PowerFeather/powerfeather-kicad-lib/3d/POGO.stp

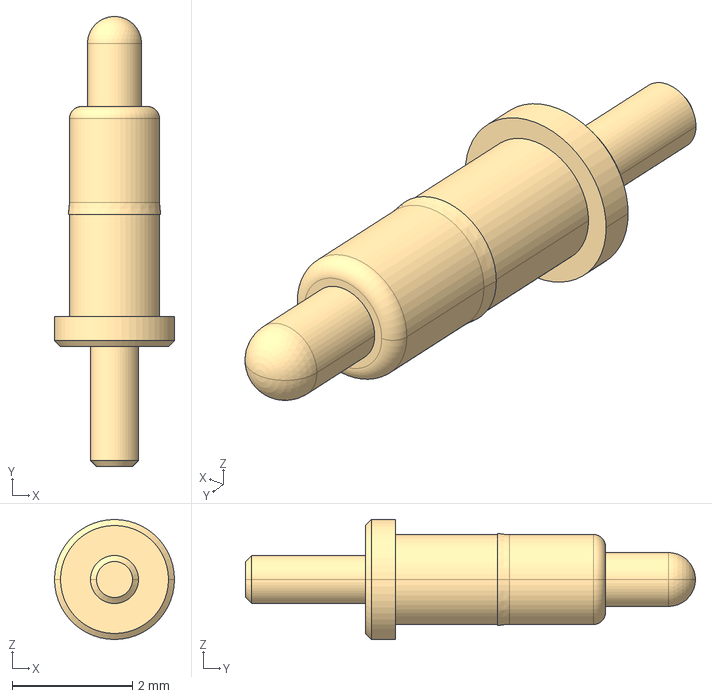
[picture p1: CAD file, 2024-10-25]
3d/POGO.stp
2.00 x 7.50 x 2.00 mm
