PowerFeather/powerfeather-kicad-lib/3d/TPS2120.STEP

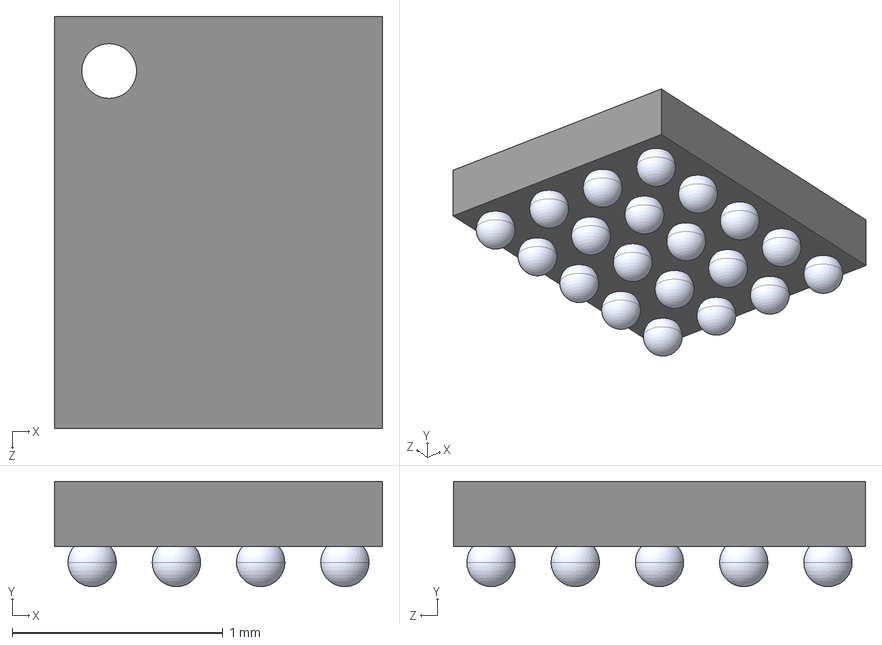
[picture p2: CAD file, 2024-10-25]
3d/TPS2120.STEP
1.56 x 0.5 x 1.96 mm
