PowerFeather/powerfeather-kicad-lib/3d/JST_SH_SM02B.STEP

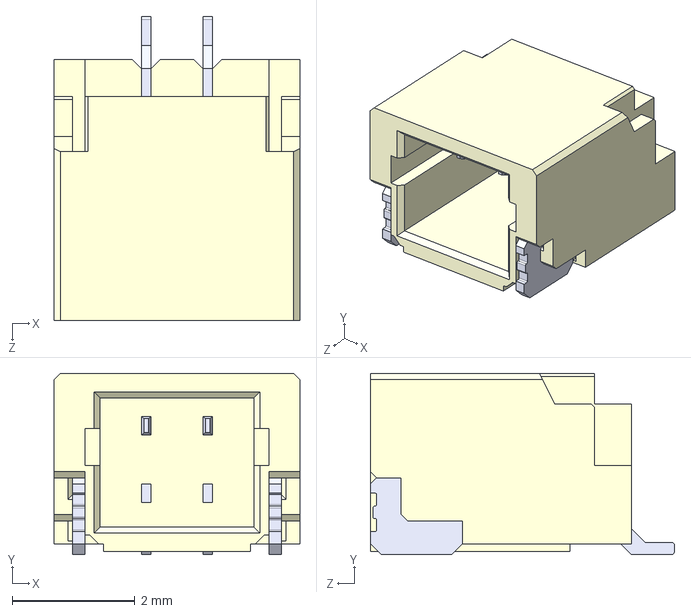
[picture p3: CAD file, 2024-10-20]
3d/JST_SH_SM02B.STEP
4.00 x 2.95 x 4.95 mm
