PowerFeather/powerfeather-kicad-lib/3d/DMN3016LFDE.STEP

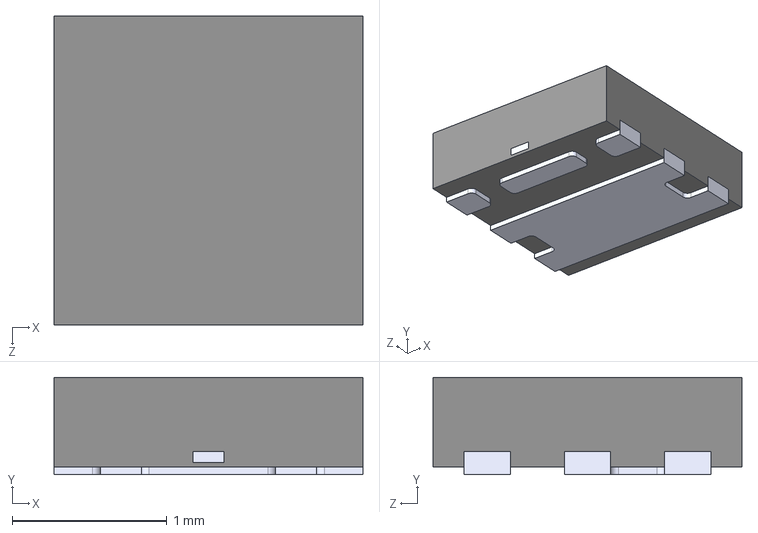
[picture p4: CAD file, 2024-10-20]
3d/DMN3016LFDE.STEP
2.00 x 0.63 x 2.00 mm
