PowerFeather/powerfeather-kicad-lib/3d/EVQP7.STEP

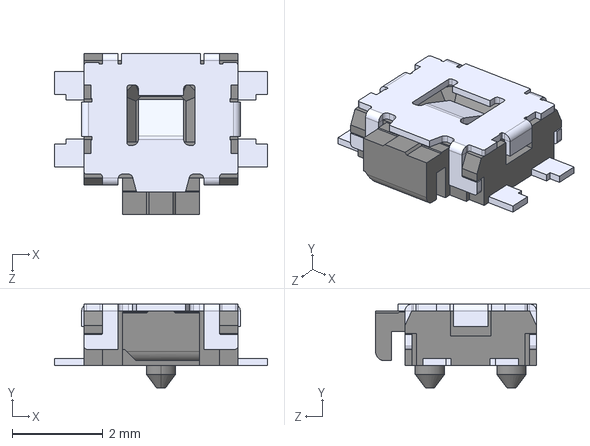
[picture p5: CAD file, 2024-10-20]
3d/EVQP7.STEP
4.70 x 1.85 x 3.55 mm
