PowerFeather/powerfeather-kicad-lib/3d/FAN48623.step

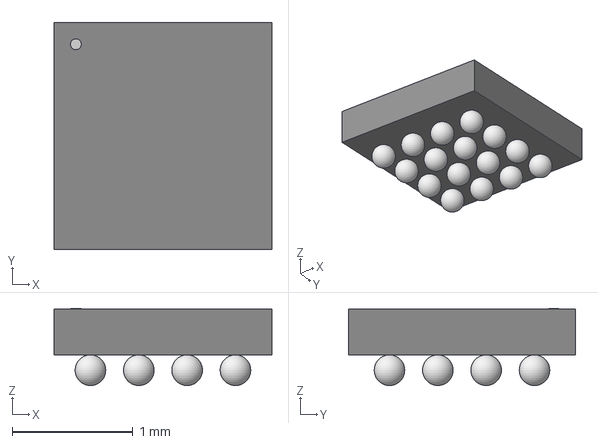
[picture p6: CAD file, 2024-10-20]
3d/FAN48623.step
1.80 x 1.88 x 0.638 mm
