PowerFeather/powerfeather-kicad-lib/3d/BQ25622E.stp

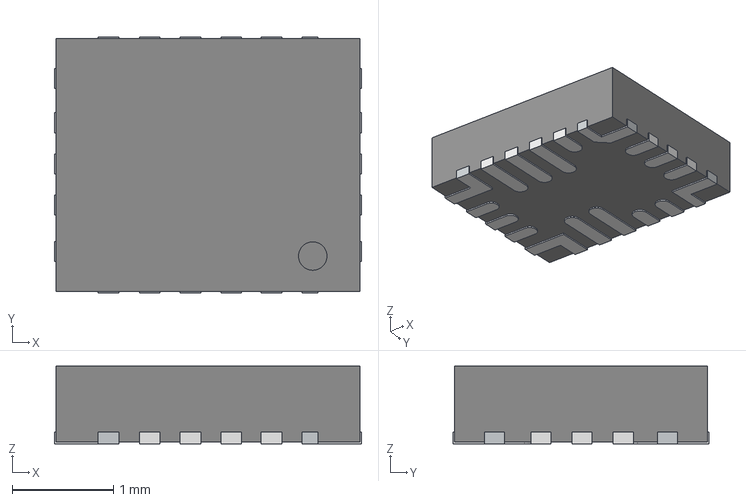
[picture p7: CAD file, 2024-10-20]
3d/BQ25622E.stp
3.03 x 2.52 x 0.77 mm
