PowerFeather/powerfeather-kicad-lib/sheets/bq25622e.kicad_sch

## KiCad design sheets/bq25622e.kicad_sch (2024-11-01)

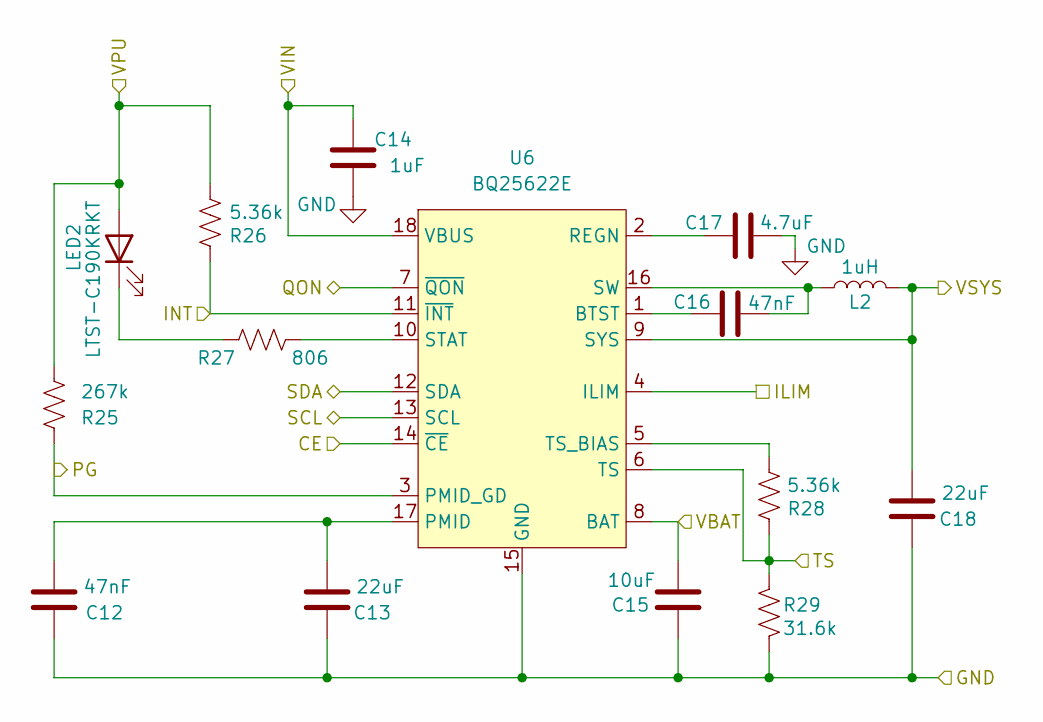
[picture p8: schematic bq25622e.kicad_sch]

Parts:
C12, C16: 47nF; C_0402_1005Metric; MPN 791-0402B473K250CT
C13, C18: 22uF; C_0805_2012Metric; MPN 187-CL21A226MAYNNNE
C14: 1uF; C_0402_1005Metric; MPN 81-GRM155R61E105MA2J
C15: 10uF; C_0603_1608Metric; MPN 187-CL10A106KP8NNWC
C17: 4.7uF; C_0603_1608Metric; MPN 187-CL10A475KP8NNND
L2: 1uH; L_1008_2520Metric; MPN 815-AOTB252010S1R0MT
LED2: LTST-C190KRKT; LED_0603_1608Metric; MPN 859-LTST-C190KRKT
R25: 267k; R_0402_1005Metric; MPN 603-AC0402FR-07267KL
R26, R28: 5.36k; R_0402_1005Metric; MPN 603-RC0402FR-135K36L
R27: 806; R_0402_1005Metric; MPN 603-RC0402FR-7W806RL
R29: 31.6k; R_0402_1005Metric; MPN 603-RC0402FR-7D31K6L
U6: BQ25622E; MPN 595-BQ25622RYKR

Connections:
CE: U6.14 (~CE)
GND: C12.2, C13.2, C14.2, C15.1, C17.1, C18.2, R29.1, U6.15 (GND)
ILIM: U6.4 (ILIM)
INT: R26.2, U6.11 (~INT)
unnamed: C12.1, C13.1, U6.17 (PMID)
unnamed: C16.1, L2.1, U6.16 (SW)
unnamed: C16.2, U6.1 (BTST)
unnamed: C17.2, U6.2 (REGN)
unnamed: LED2.1 (K), R27.1
unnamed: R27.2, U6.10 (STAT)
unnamed: R28.2, U6.5 (TS_BIAS)
PG: R25.2, U6.3 (PMID_GD)
QON: U6.7 (~QON)
SCL: U6.13 (SCL)
SDA: U6.12 (SDA)
TS: R28.1, R29.2, U6.6 (TS)
VBAT: C15.2, U6.8 (BAT)
VIN: C14.1, U6.18 (VBUS)
VPU: LED2.2 (A), R25.1, R26.1
VSYS: C18.1, L2.2, U6.9 (SYS)
