PowerFeather/powerfeather-kicad-lib/sheets/mainboard-common.kicad_sch

## KiCad design sheets/mainboard-common.kicad_sch (2024-09-26)

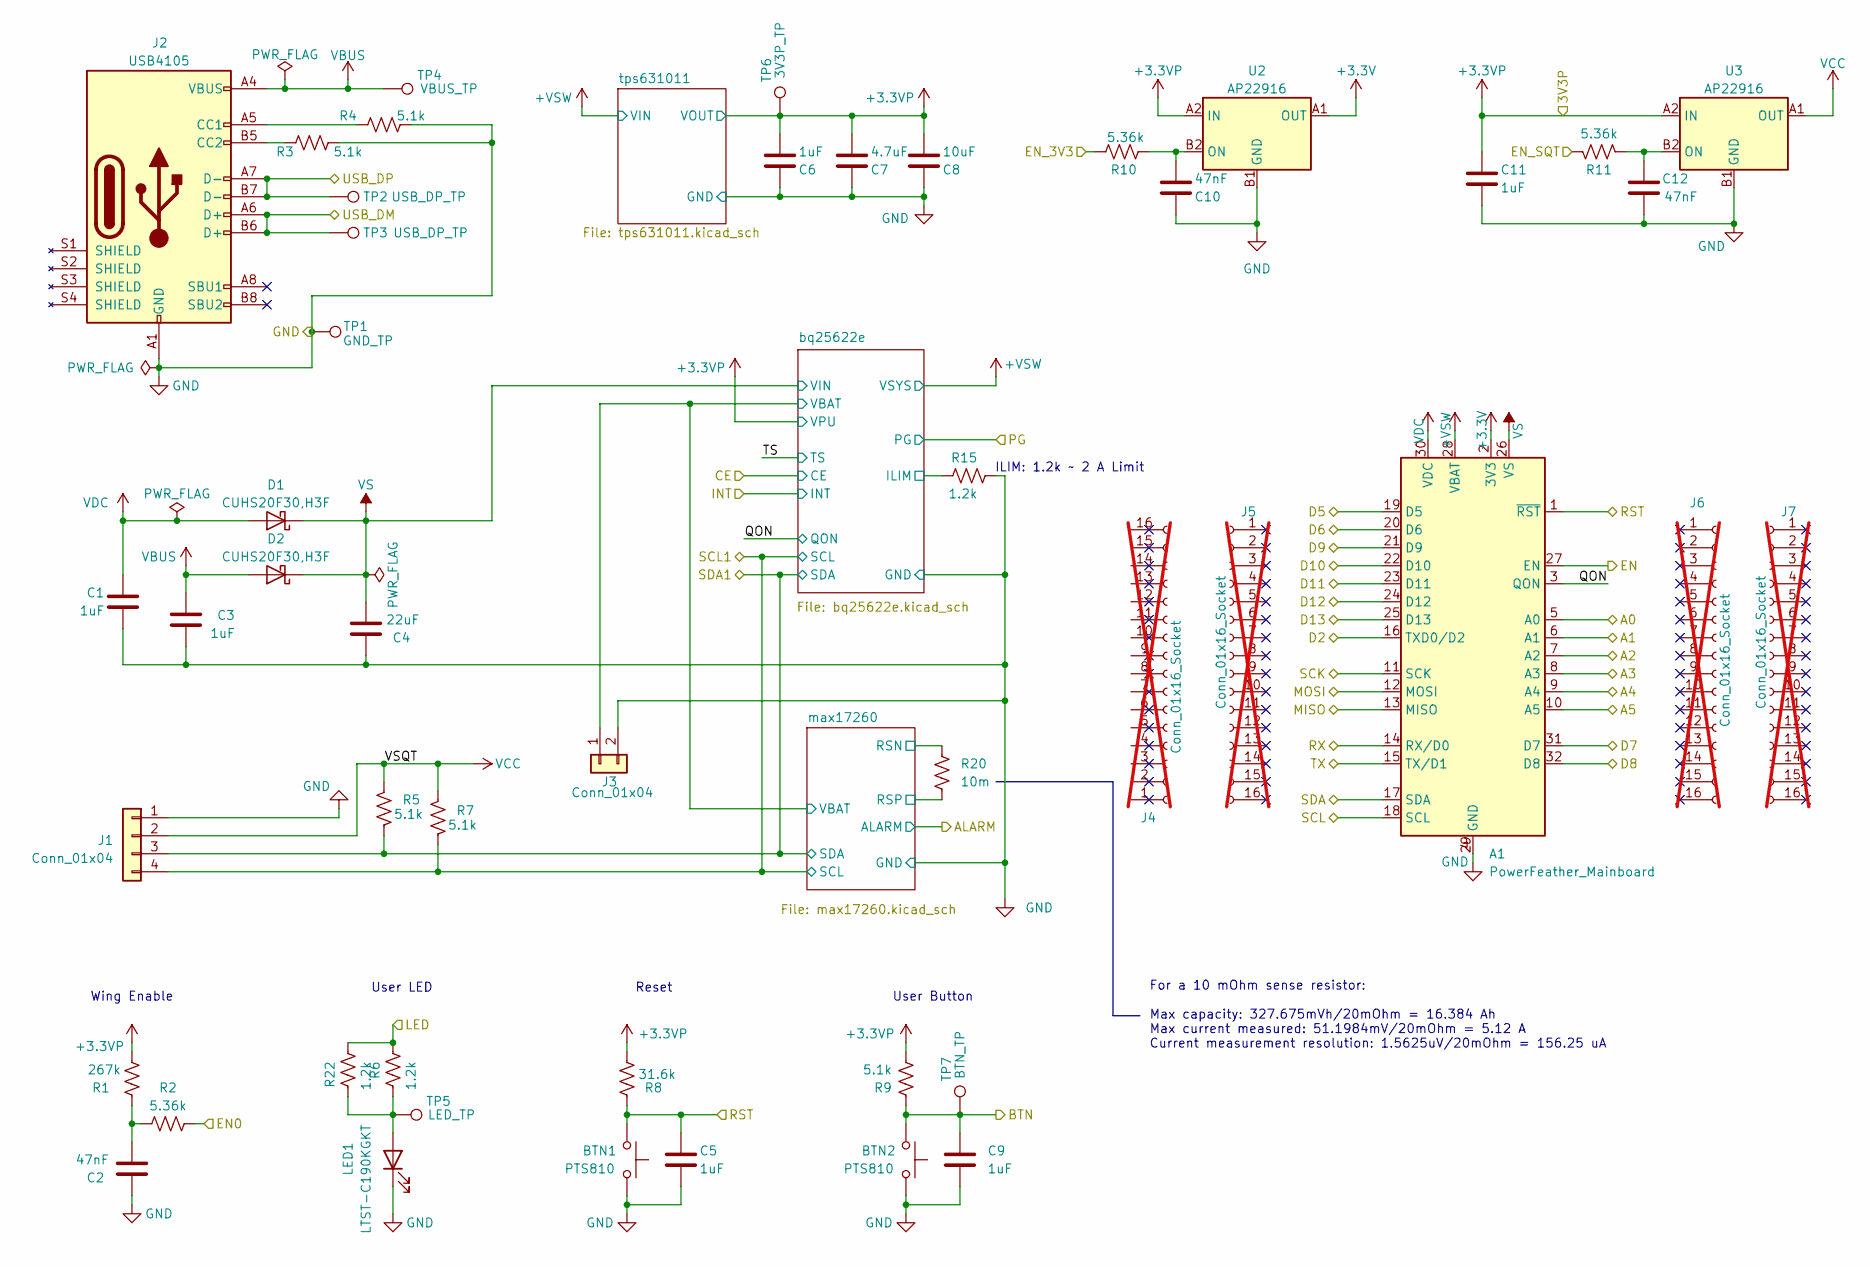
[picture p9: schematic mainboard-common.kicad_sch]

Parts:
A1: PowerFeather_Mainboard
BTN1, BTN2: PTS810; SW_SPST_PTS810; MPN 611-PTS810SJM250SMTR
C1, C3, C5, C6, C9, C11: 1uF; C_0402_1005Metric; MPN 81-GRM155R61E105MA2J
C2, C10, C12: 47nF; C_0402_1005Metric; MPN 791-0402B473K250CT
C4: 22uF; C_0805_2012Metric; MPN 187-CL21A226MAYNNNE
C7: 4.7uF; C_0603_1608Metric; MPN 187-CL10A475KP8NNND
C8: 10uF; C_0603_1608Metric; MPN 187-CL10A106KP8NNWC
D1, D2: CUHS20F30,H3F; US2H; MPN 757-CUHS20F30H3F
J1: Conn_01x04; JST_SH_BM04B-SRSS-TB_1x04-1MP_P1.00mm_Vertical; MPN 455-1790-6-ND
J2: USB4105; USB_C_Receptacle_GCT_USB4105-xx-A_16P_TopMnt_Horizontal; MPN 640-USB4105-GF-A
J3: Conn_01x04; JST_PH_S2B-PH-SM4-TB_1x02-1MP_P2.00mm_Horizontal; MPN 455-1749-6-ND
J4, J7: Conn_01x16_Socket; PinHeader_1x16_P2.54mm_Vertical; MPN 710-61301611821; not fitted
J5, J6: Conn_01x16_Socket; PinHeader_1x16_P2.54mm_Vertical; MPN 649-1012937891601BLF; not fitted
LED1: LTST-C190KGKT; LED_0603_1608Metric; MPN 859-LTST-C190KGKT
R1: 267k; R_0402_1005Metric; MPN 603-AC0402FR-07267KL
R2, R10, R11: 5.36k; R_0402_1005Metric; MPN 603-RT0402BRD075K36L
R3, R4, R5, R7, R9: 5.1k; R_0402_1005Metric; MPN 603-AC0402FR-075K1L
R6, R15, R22: 1.2k; R_0402_1005Metric
R8: 31.6k; R_0402_1005Metric; MPN 603-RT0402BRD0731K6L
R20: 10m; R_0603_1608Metric; MPN MFL0603R0150FA
TP1: GND_TP; TestPoint_Pad_D1.0mm
TP2, TP3: USB_DP_TP; TestPoint_Pad_D1.0mm
TP4: VBUS_TP; TestPoint_Pad_D1.0mm
TP5: LED_TP; TestPoint_Pad_D1.0mm
TP6: 3V3P_TP; TestPoint_Pad_D1.0mm
TP7: BTN_TP; TestPoint_Pad_D1.0mm
U2, U3: AP22916; APS22916; MPN 621-AP22916DCA4-7

Connections:
+3.3V: A1.2 (3V3), U2.A1 (OUT)
+3.3VP: C6.1, C7.1, C8.1, C11.1, R1.1, R8.2, R9.2, TP6.1, U2.A2 (IN), U3.A2 (IN)
+VSW: A1.28 (VBAT)
A0: A1.5 (A0)
A1: A1.6 (A1)
A2: A1.7 (A2)
A3: A1.8 (A3)
A4: A1.9 (A4)
A5: A1.10 (A5)
BTN: BTN2.1, C9.2, R9.1, TP7.1
D2: A1.16 (TXD0/D2)
D5: A1.19 (D5)
D6: A1.20 (D6)
D7: A1.31 (D7)
D8: A1.32 (D8)
D9: A1.21 (D9)
D10: A1.22 (D10)
D11: A1.23 (D11)
D12: A1.24 (D12)
D13: A1.25 (D13)
EN: A1.27 (EN)
EN0: R2.2
EN_3V3: R10.1
EN_SQT: R11.2
GND: A1.4 (GND), A1.29 (GND), BTN1.2, BTN2.2, C1.2, C2.2, C3.2, C4.2, C5.1, C6.2, C7.2, C8.2, C9.1, C10.1, C11.2, C12.1, J1.1, J2.A1 (GND), J2.A12 (GND), J2.B1 (GND), J2.B12 (GND), J3.2, LED1.1 (K), R3.2, R4.2, R15.2, TP1.1, U2.B1 (GND), U3.B1 (GND)
ILIM: R15.1
LED: R6.2, R22.2
MISO: A1.13 (MISO)
MOSI: A1.12 (MOSI)
unnamed: C2.1, R1.2, R2.1
unnamed: C10.2, R10.2, U2.B2 (ON)
unnamed: C12.2, R11.1, U3.B2 (ON)
unnamed: J2.A5 (CC1), R4.1
unnamed: J2.B5 (CC2), R3.1
unnamed: LED1.2 (A), R6.1, R22.1, TP5.1
QON: A1.3 (QON)
RSN: R20.1
RSP: R20.2
RST: A1.1 (~RST), BTN1.1, C5.2, R8.1
RX: A1.14 (RX/D0)
SCK: A1.11 (SCK)
SCL: A1.18 (SCL)
SCL1: J1.4, R7.2
SDA: A1.17 (SDA)
SDA1: J1.3, R5.2
TX: A1.15 (TX/D1)
USB_DM: J2.A6 (D+), J2.B6 (D+), TP3.1
USB_DP: J2.A7 (D-), J2.B7 (D-), TP2.1
VBAT: J3.1
VBUS: C3.1, D2.2 (A), J2.A4 (VBUS), J2.A9 (VBUS), J2.B4 (VBUS), J2.B9 (VBUS), TP4.1
VCC: J1.2, R5.1, R7.1, U3.A1 (OUT)
VDC: A1.30 (VDC), C1.1, D1.2 (A)
VS: A1.26 (VS), C4.1, D1.1 (K), D2.1 (K)

Notes on the sheet:
For a 10 mOhm sense resistor: Max capacity: 327.675mVh/20mOhm = 16.384 Ah Max current measured: 51.1984mV/20mOhm = 5.12 A Current measurement resolution: 1.5625uV/20mOhm = 156.25 uA
Reset
Wing Enable
User LED
User Button
ILIM: 1.2k ~ 2 A Limit
