PowerFeather/powerfeather-kicad-lib/sheets/max17260.kicad_sch

## KiCad design sheets/max17260.kicad_sch (2024-11-01)

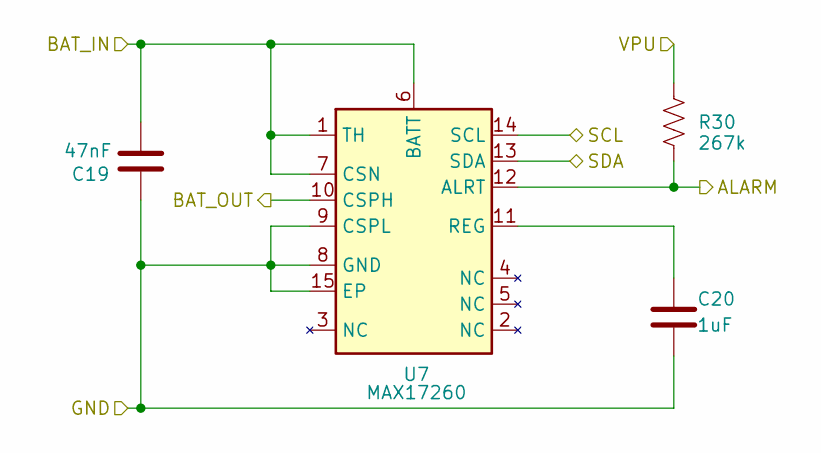
[picture p10: schematic max17260.kicad_sch]

Parts:
C19: 47nF; C_0402_1005Metric; MPN 791-0402B473K250CT
C20: 1uF; C_0402_1005Metric; MPN 81-GRM155R61E105MA2J
R30: 267k; R_0402_1005Metric; MPN 603-AC0402FR-07267KL
U7: MAX17260; TDFN-14-1EP_3x3mm_P0.4mm_EP1.78x2.35mm; MPN 700-MAX17260SETD+T

Connections:
ALARM: R30.2, U7.12 (ALRT)
BAT_IN: C19.1, U7.1 (TH), U7.6 (BATT), U7.7 (CSN)
BAT_OUT: U7.10 (CSPH)
GND: C19.2, C20.2, U7.8 (GND), U7.9 (CSPL), U7.15 (EP)
unnamed: C20.1, U7.11 (REG)
SCL: U7.14 (SCL)
SDA: U7.13 (SDA)
VPU: R30.1
