PowerFeather/powerfeather-kicad-lib/(threads)

Thread 1 (2024-11-30):

Battery temperature sensor connector

matthias-bs, 2024-11-30:
Hi,

I'd appreciate a separate 2-pin connector (TS and GND) with a pitch on 2.54 mm for the battery temperature sensor instead of the single pad (which is off the regular 2,54 mm grid). I know that there is not much space left, but maybe this is feasible.

Best regards,
Matthias

powerfeatherdev, 2024-12-22:
Hi @matthias-bs , will take this into consideration in the next revision (no promises though, as you said there is barely space on the board).
