PowerFeather/powerfeather-kicad-lib/(commit log)

2024-08-27 Fix mainboard footprint
2024-08-27 Fix mainboard symbol footprint
2024-09-07 Initial common heirarchical sheets
    [bq25622e.kicad_sch, mainboard-common.kicad_sch, max17260.kicad_sch, tps631011.kicad_sch, xc6220.kicad_sch]
2024-09-07 More cleanup
    [mainboard-common.kicad_sch, max17260.kicad_sch, tps631011.kicad_sch]
2024-09-08 Fix max17260 schematic
    [bq25622e.kicad_sch, mainboard-common.kicad_sch, max17260.kicad_sch]
2024-09-08 Fix powerfeather symbol
    [mainboard-common.kicad_sch]
2024-09-08 Bring out ILIM
    [bq25622e.kicad_sch, mainboard-common.kicad_sch]
2024-09-08 Use same 1.2k for LED
    [mainboard-common.kicad_sch]
2024-09-14 Change sense resistor value
    [mainboard-common.kicad_sch]
2024-09-25 Some changes for powerups
    [bq25622e.kicad_sch, max17260.kicad_sch, tps631013.kicad_sch]
2024-09-26 Change rsense value
    [mainboard-common.kicad_sch]
2024-09-26 Some changes
    [bq25622e.kicad_sch, max17260.kicad_sch, tps631011.kicad_sch]
2024-09-26 Changes to fuel gauge and charger sheets
    [bq25622e.kicad_sch, max17260.kicad_sch]
2024-09-27 Run designator annotations
    [bq25622e.kicad_sch, max17260.kicad_sch]
2024-09-27 Fix warnings
    [bq25622e.kicad_sch]
2024-10-09 Add shunt footprint
2024-10-10 Renumber components for powerups
    [bq25622e.kicad_sch, max17260.kicad_sch]
2024-10-11 Fix max17260 circuit
    [max17260.kicad_sch]
2024-10-11 Remove unecessary symbols
    [bq25622e.kicad_sch, max17260.kicad_sch, tps631011.kicad_sch, tps631013.kicad_sch, xc6220.kicad_sch]
2024-10-11 Change some values
    [max17260.kicad_sch]
2024-10-11 Remove unneeded field
    [max17260.kicad_sch]
2024-10-11 Some cleanup
    [bq25622e.kicad_sch]
2024-10-12 Slight description change
    [bq25622e.kicad_sch]
2024-10-12 Fill in missing component details
    [bq25622e.kicad_sch, max17260.kicad_sch]
2024-10-12 Fix pcb import warnings
    [bq25622e.kicad_sch]
2024-10-14 Replace ap22916
    [max17260.kicad_sch]
2024-10-14 Change max17260 footprint
    [max17260.kicad_sch]
2024-10-18 Add VPU to max17260
    [max17260.kicad_sch]
2024-10-20 Add missing 3d models
    [BQ25622E.stp, DMN3016LFDE.STEP, EVQP7.STEP, FAN48623.step, JST_SH_SM02B.STEP]
2024-10-25 Add tps2120 footprint and model
    [TPS2120.STEP]
2024-10-25 Add pogo step file
    [POGO.stp]
2024-10-25 Add pin numbers for tps2120
2024-10-25 Remove solder mask on tps2120
2024-10-26 Change out values of some parts
    - Fix max17260 sku
    - Use 800 ohms for stat pin
    - Change charger inductor value
    [bq25622e.kicad_sch, max17260.kicad_sch]
2024-11-01 Add fan48623 footprint
2024-11-01 Add solder mask openings
2024-11-01 Update sheets version
    [bq25622e.kicad_sch, max17260.kicad_sch]
2024-11-01 Use proper resistor value
    [bq25622e.kicad_sch]
2024-11-10 Fix NCV68261 footprint and symbol
